hitsmaxft/waveshare-esp32s3-amoled-crt-case-step/STEP/assembly-v50.stp

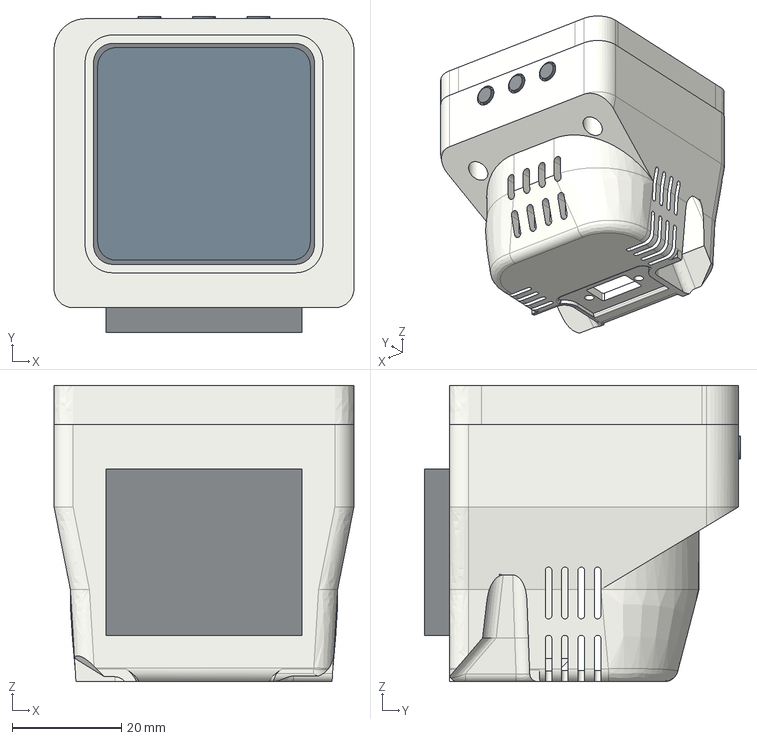
[picture p2: CAD file, 2026-10-10]
STEP/assembly-v50.stp
55.0 x 58.0 x 54.3 mm
