hitsmaxft/waveshare-esp32s3-amoled-crt-case-step/STEP/parts/three-foot-20deg-base.stp

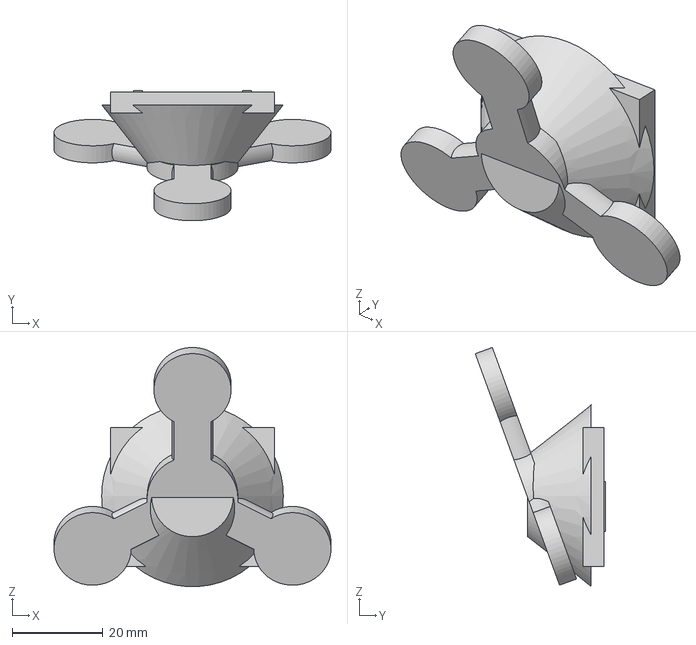
[picture p3: CAD file, 2026-10-10]
STEP/parts/three-foot-20deg-base.stp
61.0 x 28.7 x 52.6 mm
