hitsmaxft/waveshare-esp32s3-amoled-crt-case-step/STEP/parts/left-upper-pcb-spacer.stp

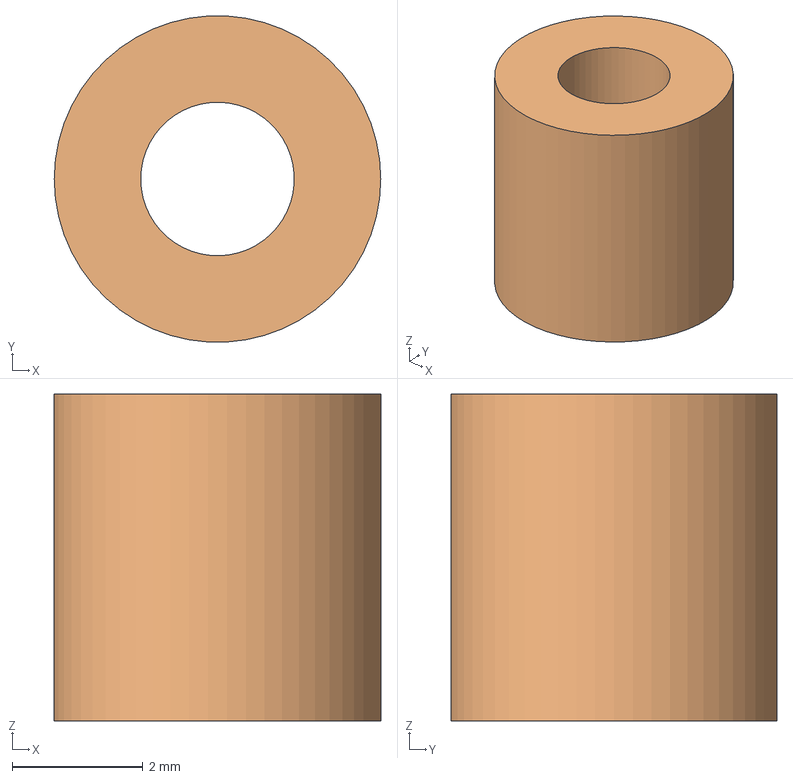
[picture p4: CAD file, 2026-10-10]
STEP/parts/left-upper-pcb-spacer.stp
5.00 x 4.99 x 5.00 mm
