hitsmaxft/waveshare-esp32s3-amoled-crt-case-step/STEP/parts/three-buttons-w.stp

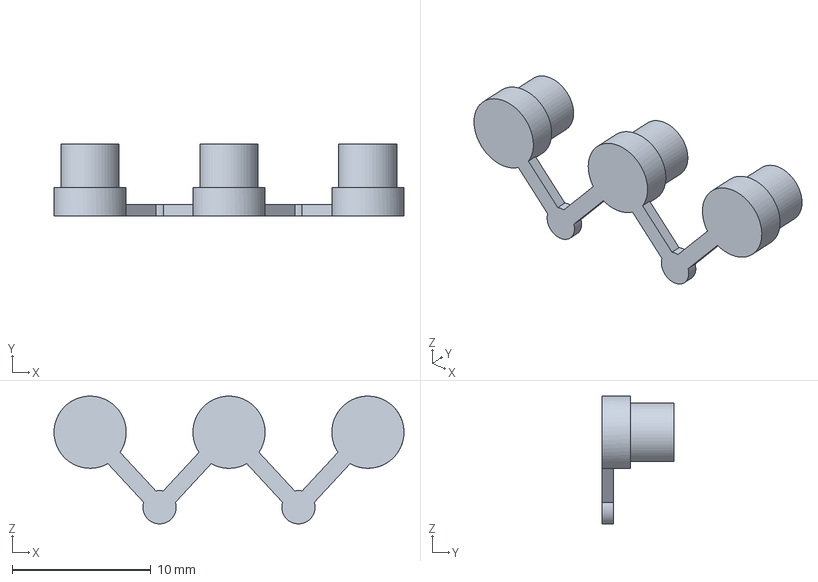
[picture p5: CAD file, 2026-10-10]
STEP/parts/three-buttons-w.stp
25.2 x 5.15 x 9.20 mm
