hitsmaxft/waveshare-esp32s3-amoled-crt-case-step/STEP/parts/round-20deg-base.stp

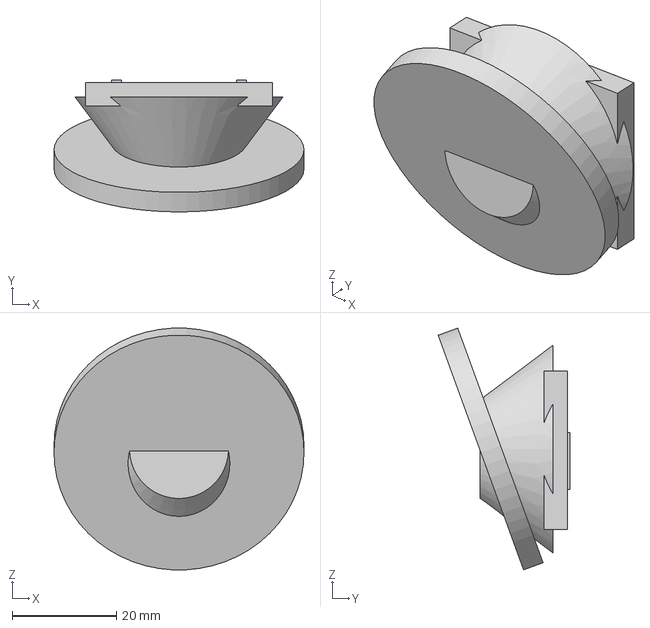
[picture p6: CAD file, 2026-10-10]
STEP/parts/round-20deg-base.stp
48.0 x 25.3 x 46.4 mm
