hitsmaxft/waveshare-esp32s3-amoled-crt-case-step/STEP/parts/front-fascia.stp

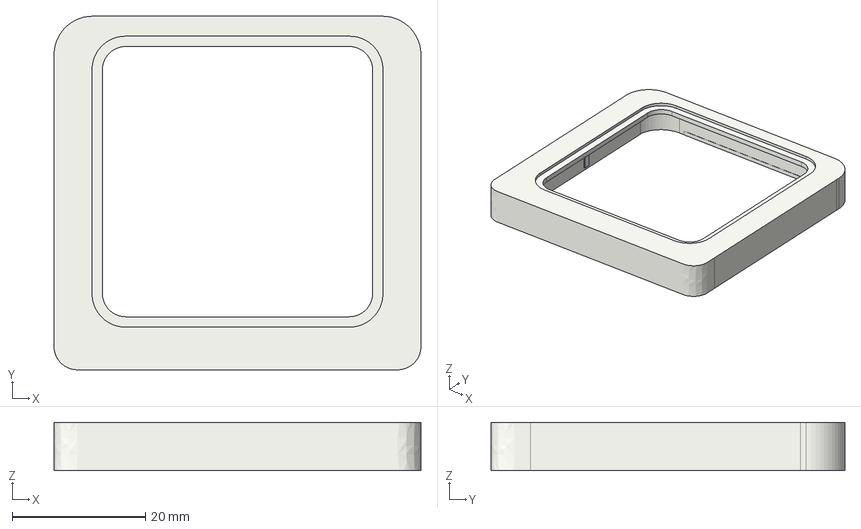
[picture p7: CAD file, 2026-10-10]
STEP/parts/front-fascia.stp
55.0 x 53.0 x 7.20 mm
