hitsmaxft/waveshare-esp32s3-amoled-crt-case-step/STEP/parts/rear-shell.stp

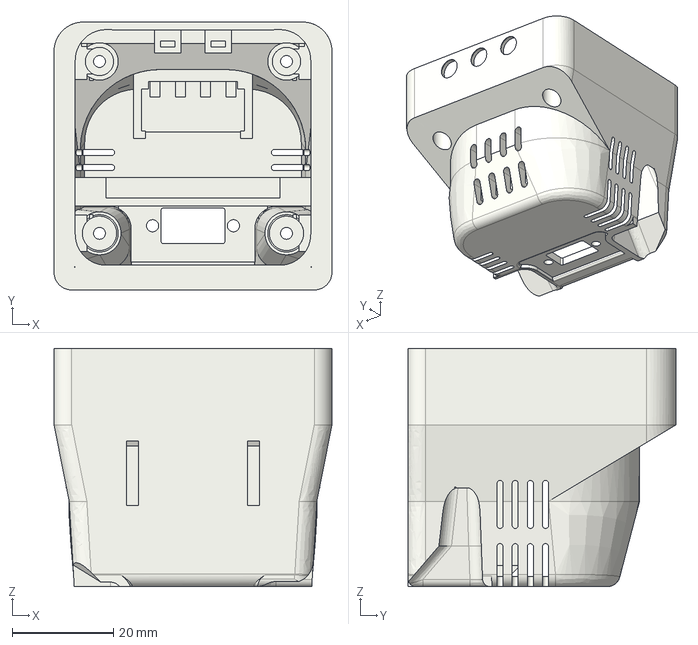
[picture p8: CAD file, 2026-10-10]
STEP/parts/rear-shell.stp
55.0 x 53.0 x 47.1 mm
