hitsmaxft/waveshare-esp32s3-amoled-crt-case-step/STEP/parts/low-glue-base.stp

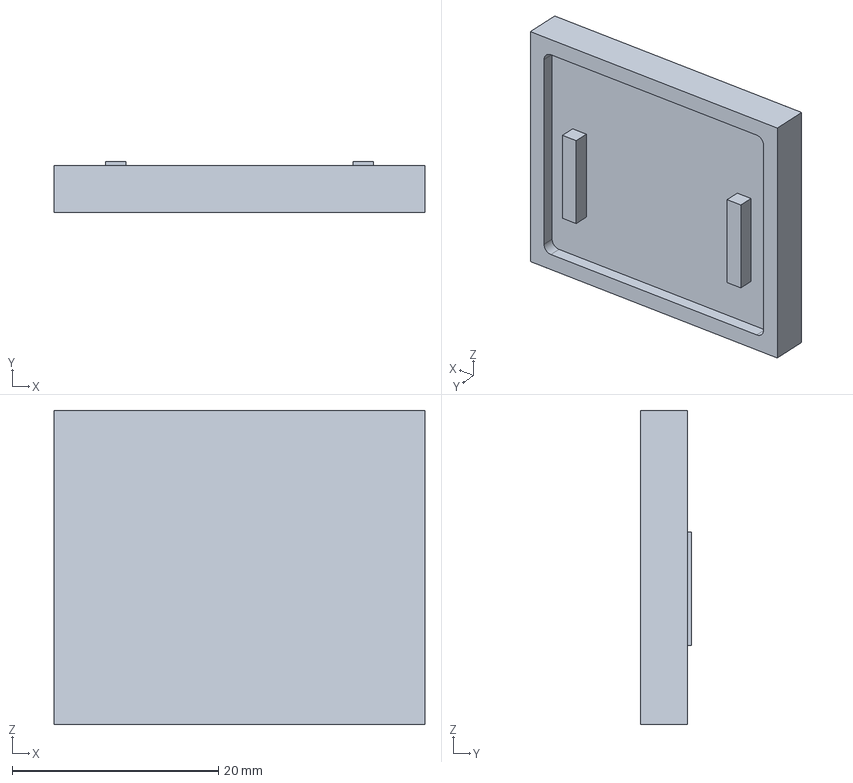
[picture p9: CAD file, 2026-10-10]
STEP/parts/low-glue-base.stp
36.0 x 4.95 x 30.5 mm
