hitsmaxft/waveshare-esp32s3-amoled-crt-case-step/(list of files, cad)

Other CAD files:
STEP/parts/right-upper-pcb-spacer.stp
STEP/parts/right-lower-pcb-spacer.stp
STEP/parts/left-lower-pcb-spacer.stp
